LGGZi/Simple-n-cheap-A-pretty-nice-one-hand-Hall-Effect-Magnetic-Switch-Keyboard/PCB/BOM_Board1_Schematic1_2026-09-07.xlsx

No. | Quantity | Comment | Designator | Footprint | Value | Manufacturer Part | Manufacturer | Supplier Part | Supplier
1 | 1 | 470nF | C1 | C0603 | 470nF | CC0603KRX7R7BB474 | YAGEO(国巨) | C106851 | LCSC
2 | 6 | 100nF | C2,C3,C4,C5,C6,C7 | C0603 | 100nF | C0603C104J5RAC | KEMET(基美) | C490602 | LCSC
3 | 1 | 1uF | C8 | C0603 | 1uF | CL10A105KB8NNNC | SAMSUNG(三星) | C15849 | LCSC
4 | 2 | 22pF | C9,C10 | C0603 |  | CL10C220JB81PNC | SAMSUNG | C170132 | LCSC
5 | 14 | 100nF | C11,C12,C13,C14,C21,C22,C23,C24,C32,C33,C35,C36,C37,C38 | C0402 | 100nF | CL05B104KB54PNC | SAMSUNG(三星) | C307331 | LCSC
6 | 14 | 1uF | C15,C16,C17,C18,C19,C20,C25,C26,C27,C28,C29,C30,C39,C40 | C0402 | 1uF | GRM155R61E105KA12D | muRata(村田) | C77009 | LCSC
7 | 1 | Switch3x4x2 | KEY1 | KEY-3.0*4.0 |  | Switch3x4x2 | ReliaPro | C26638 | LCSC
8 | 1 | ATMEGA32U4-AU | MCU1 | QFP-44_L10.0-W10.0-P0.80-LS13.2-BL |  | ATMEGA32U4-AU | MICROCHIP(美国微芯) | C44854 | LCSC
9 | 1 | 1K | R1 | R0805 |  | TC0525F1001T5E | UniOhm | C75781 | LCSC
10 | 2 | 5.1K | R2,R3 | R0805 |  | 0805W8F5101T5E | UniOhm | C27834 | LCSC
11 | 1 | 10K | R4 | R0805 |  | 0805W8F1002T5E | UniOhm | C17414 | LCSC
12 | 3 | 1.5kΩ | R5,R6,R7 | R0402 | 1.5kΩ | 0402WGF1501TCE | UNI-ROYAL(厚声) | C25867 | LCSC
13 | 1 | 10kΩ | R8 | R0603 | 10kΩ | 0603WAF1002T5E | UNI-ROYAL(厚声) | C25804 | LCSC
14 | 2 | 22 | R9,R10 | R0603 |  | 0603WAF220JT5E | UniOhm | C23345 | LCSC
15 | 1 | 1kΩ | R11 | R0603 | 1kΩ | RC0603FR-071KL | YAGEO(国巨) | C22548 | LCSC
16 | 4 | M3螺丝 | SCREW1,SCREW2,SCREW3,SCREW4 | M3螺丝
17 | 1 | EC11E15244B2 | SW1 | 旋转编码器
18 | 1 | MF-NSMF050-2 | U1 | F1206 |  | MF-NSMF050-2 | BOURNS | C75464 | LCSC
19 | 14 | CH605ASR | U2,U3,U4,U5,U6,U7,U8,U9,U11,U12,U14,U15,U16,U17 | SOT-23-3_L2.9-W1.6-P1.90-LS2.8-BR |  | CH605ASR | COSEMITECH(意瑞) | C455296 | LCSC
20 | 2 | CD74HC4051M96 | U4057-1,U4058-1 | SOIC-16_L9.9-W3.9-P1.27-LS6.0-BL |  | CD74HC4051M96 | TI(德州仪器) | C132065 | LCSC
21 | 14 | Yo-WS2812B-3528反贴雾状 | UL1,UL2,UL3,UL4,UL5,UL6,UL7,UL8,UL9,UL10,UL11,UL12,UL13,UL14 | LED-SMD_L3.2-W2.8-BR_DY-S352818 |  | Yo-WS2812B-3528反贴雾状 | null | C9900003682 | LCSC
22 | 1 | PRTR5V0U2X | UPRT1 | SOT-143_L2.9-W1.3-P1.92-LS2.3-BL |  | PRTR5V0U2X | Yenji Elec | C330092 | LCSC
23 | 1 | TYPE-C-31-M-12 | USBC1 | USB-C_SMD-TYPE-C-31-M-12 |  | TYPE-C-31-M-12 | Rectangular Connectors - Contacts | C165948 | LCSC
24 | 1 | 16MHz | X1 | OSC-SMD_4P-L3.2-W2.5-BL |  | X322516MRB4SI | YXC | C70562 | LCSC
