LGGZi/Simple-n-cheap-A-pretty-nice-one-hand-Hall-Effect-Magnetic-Switch-Keyboard/PCB/PCB_PCB1_2026-09-07.pdf

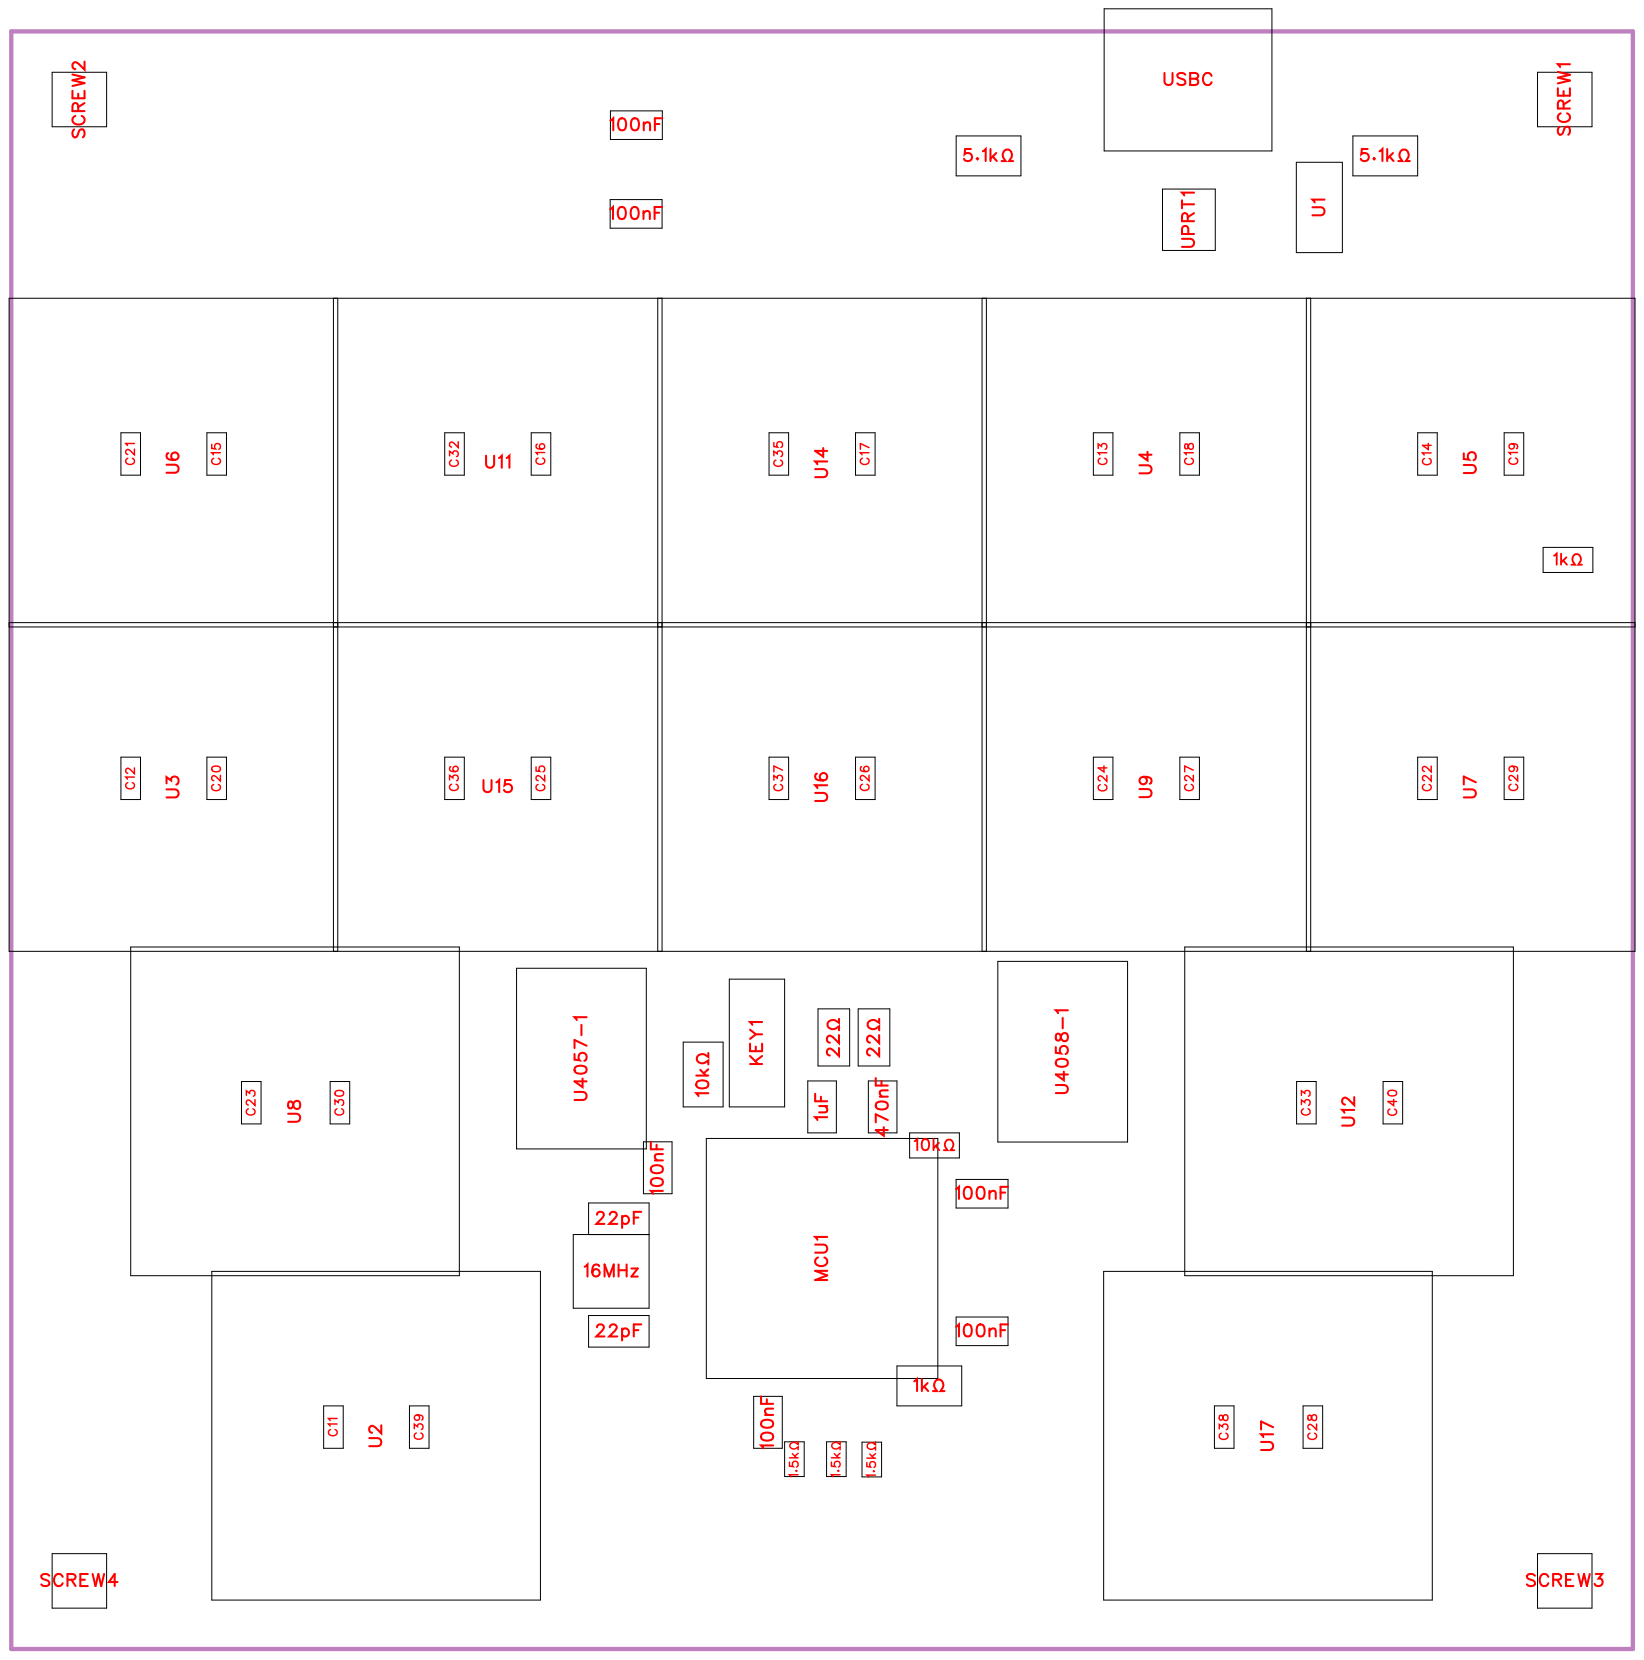
[picture p1: page 1]

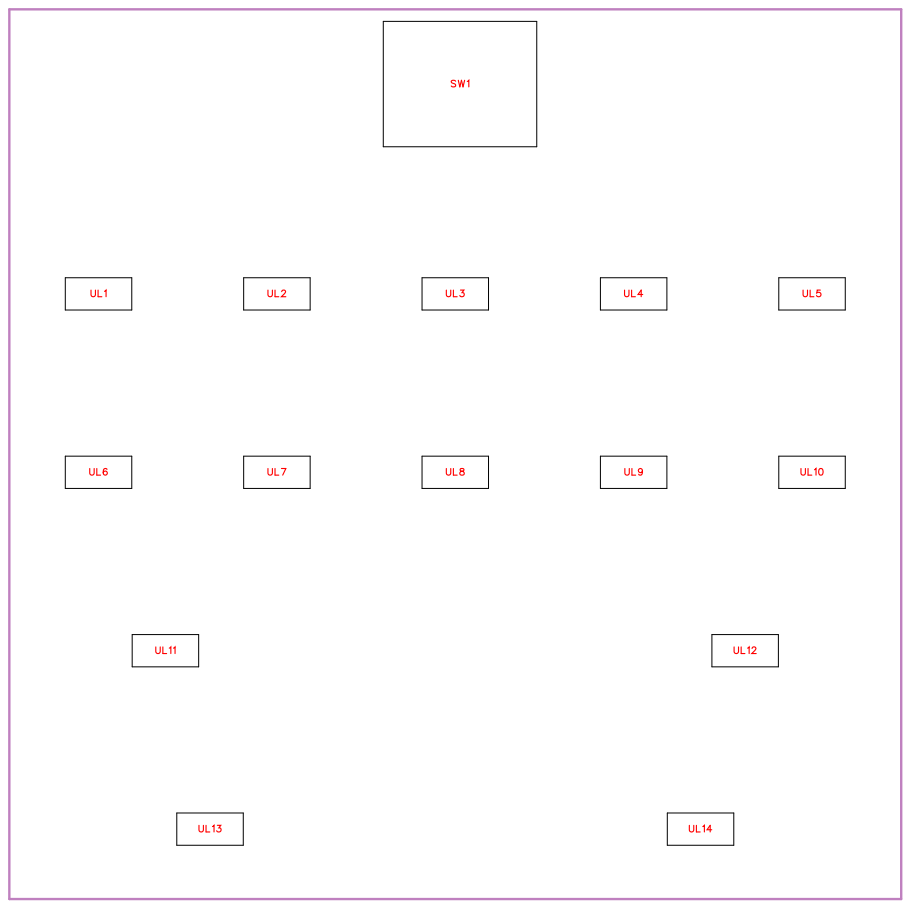
[picture p2: page 2]

No. | Quantity | Comment | Designator | Footprint | Value | Manufacturer Part | Manufacturer | Supplier Part | Supplier
1 | 1 | 1K | 1k | R0805 | | TC0525F100 1T5E | UniOhm | C75781 | LCSC
2 | 1 | 1k | 1k | R0603 | 1k | RC0603FR-0 71KL | YAGEO(国巨 ) | C22548 | LCSC
3 | 1 | 1uF | 1uF | C0603 | 1uF | CL10A105KB 8NNNC | SAMSUNG( 三星) | C15849 | LCSC
4 | 3 | 1.5k | 1.5k ,1.5k ,1.5k | R0402 | 1.5k | 0402WGF15 01TCE | UNI-ROYAL( 厚声) | C25867 | LCSC
5 | 2 | 5.1K | 5.1k ,5.1k | R0805 | | 0805W8F510 1T5E | UniOhm | C27834 | LCSC
6 | 1 | 10K | 10k | R0805 | | 0805W8F100 2T5E | UniOhm | C17414 | LCSC
7 | 1 | 10k | 10k | R0603 | 10k | 0603WAF10 02T5E | UNI-ROYAL( 厚声) | C25804 | LCSC
8 | 1 | 16MHz | 16MHz | OSC-SMD_4 P-L3.2-W2.5-BL | | X322516MR B4SI | YXC | C70562 | LCSC
9 | 2 | 22pF | 22pF,22pF | C0603 | | CL10C220JB 81PNC | SAMSUNG | C170132 | LCSC
10 | 2 | 22 | 22 ,22 | R0603 | | 0603WAF22 0JT5E | UniOhm | C23345 | LCSC
11 | 6 | 100nF | 100nF,100nF,100nF,100nF, 100nF,100nF | C0603 | 100nF | C0603C104J 5RAC | KEMET(基美 ) | C490602 | LCSC
12 | 1 | 470nF | 470nF | C0603 | 470nF | CC0603KRX 7R7BB474 | YAGEO(国巨 ) | C106851 | LCSC
13 | 14 | 100nF | C11,C12,C13,C14,C21,C22 ,C23,C24,C32,C33,C35,C3 6,C37,C38 | C0402 | 100nF | CL05B104KB 54PNC | SAMSUNG( 三星) | C307331 | LCSC
14 | 14 | 1uF | C15,C16,C17,C18,C19,C20 ,C25,C26,C27,C28,C29,C3 0,C39,C40 | C0402 | 1uF | GRM155R61 E105KA12D | muRata(村田 ) | C77009 | LCSC
15 | 1 | Switch3x4x2 | KEY1 | KEY-3.0*4.0 | | Switch3x4x2 | ReliaPro | C26638 | LCSC
16 | 1 | ATMEGA32U 4-AU | MCU1 | QFP-44_L10. 0-W10.0-P0. 80-LS13.2-B L | | ATMEGA32U 4-AU | MICROCHIP( 美国微芯) | C44854 | LCSC
17 | 4 | M3螺丝 | SCREW1,SCREW2,SCRE W3,SCREW4 | M3螺丝
18 | 1 | EC11E15244 B2 | SW1 | 旋转编码器
19 | 1 | MF-NSMF05 0-2 | U1 | F1206 | | MF-NSMF05 0-2 | BOURNS | C75464 | LCSC
20 | 14 | CH605ASR | U2,U3,U4,U5,U6,U7,U8,U9, U11,U12,U14,U15,U16,U17 | SOT-23-3_L2 .9-W1.6-P1.9 0-LS2.8-BR | | CH605ASR | COSEMITEC H(意瑞) | C455296 | LCSC
21 | 2 | CD74HC405 1M96 | U4057-1,U4058-1 | SOIC-16_L9. 9-W3.9-P1.2 7-LS6.0-BL | | CD74HC405 1M96 | TI(德州仪器) | C132065 | LCSC

22 | 14 | Yo-WS2812B -3528反贴雾 状 | UL1,UL2,UL3,UL4,UL5,UL6 ,UL7,UL8,UL9,UL10,UL11, UL12,UL13,UL14 | LED-SMD_L 3.2-W2.8-BR _DY-S35281 8 | Yo-WS2812B -3528反贴雾 状 | null | C990000368 2 | LCSC
23 | 1 | PRTR5V0U2 X | UPRT1 | SOT-143_L2. 9-W1.3-P1.9 2-LS2.3-BL | PRTR5V0U2 X | Yenji Elec | C330092 | LCSC
24 | 1 | TYPE-C-31-M-12 | USBC | USB-C_SMD -TYPE-C-31-M-12 | TYPE-C-31-M-12 | Rectangular Connectors -Contacts | C165948 | LCSC

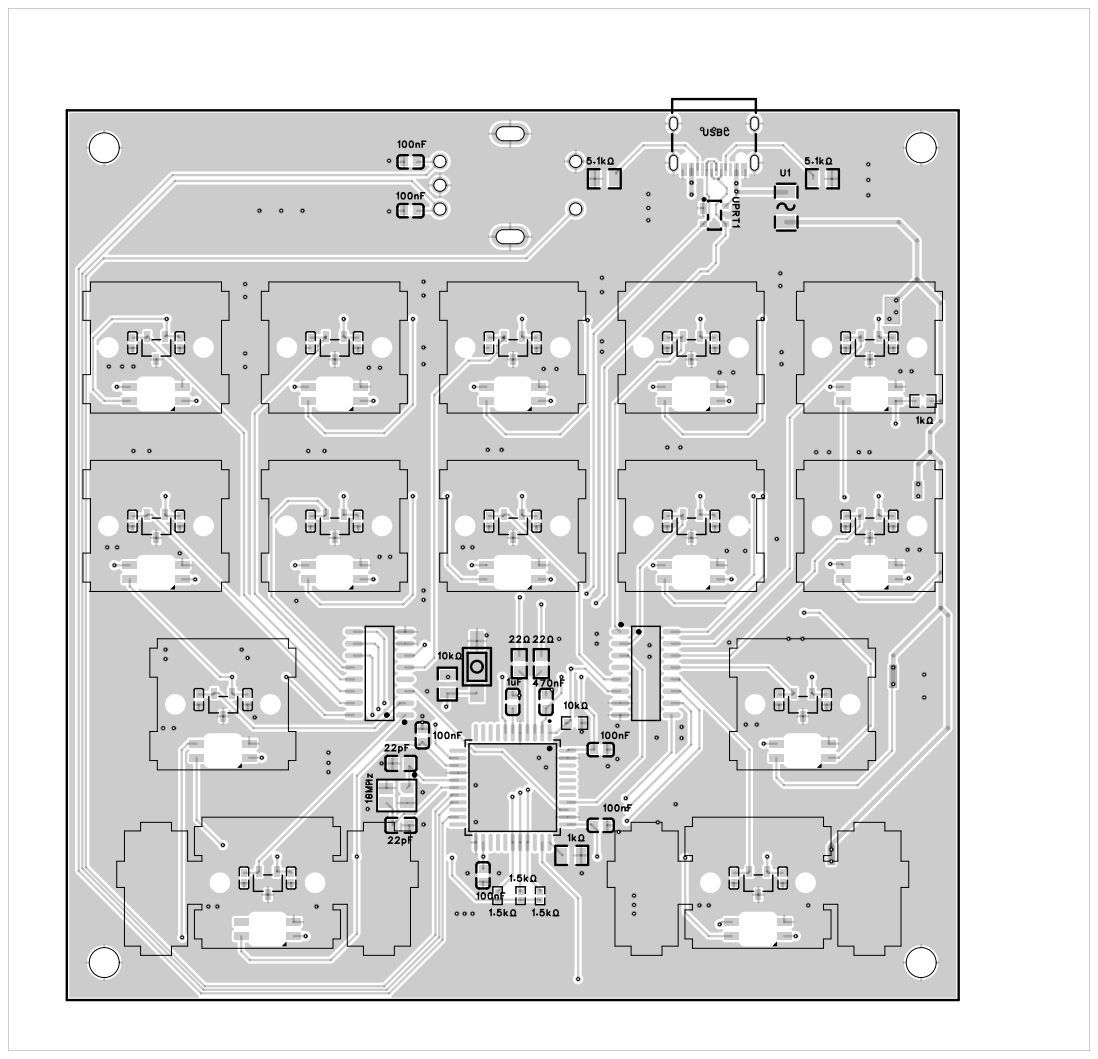
[picture p3: page 5]

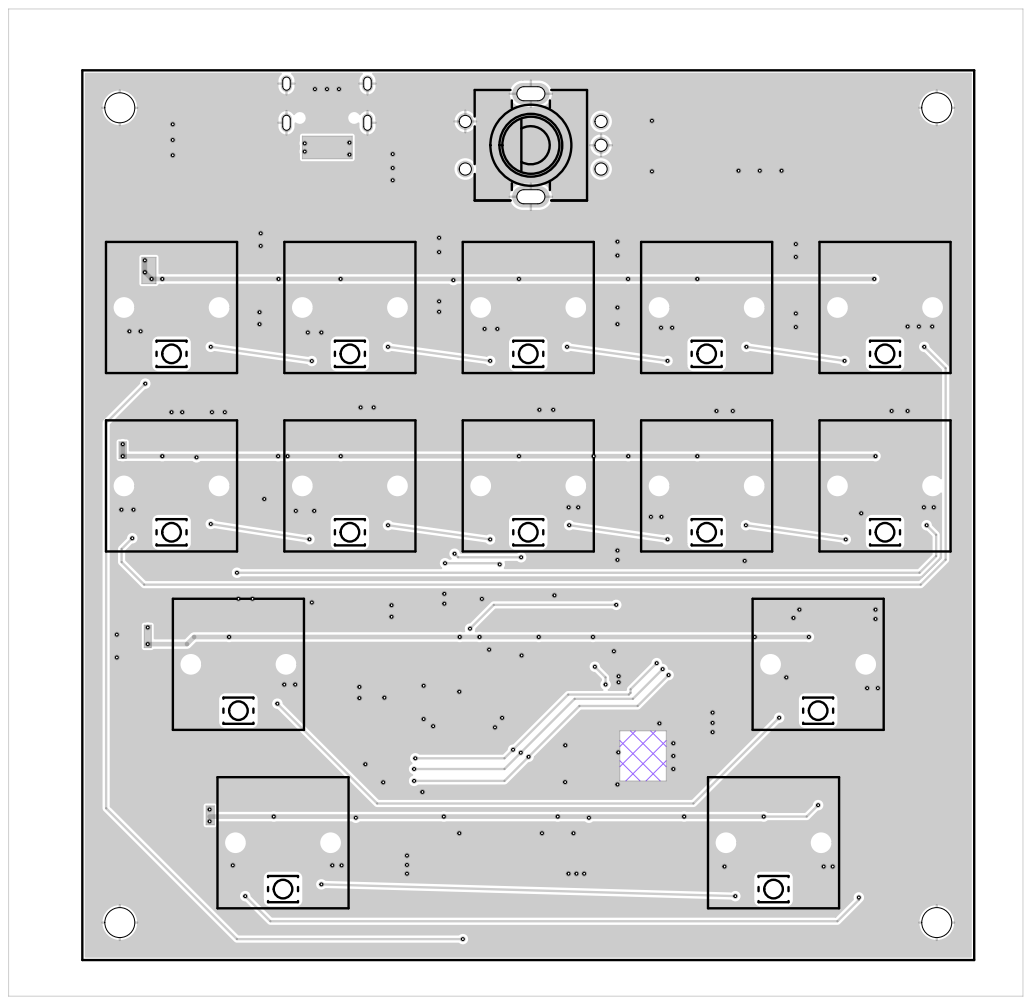
[picture p4: page 6]

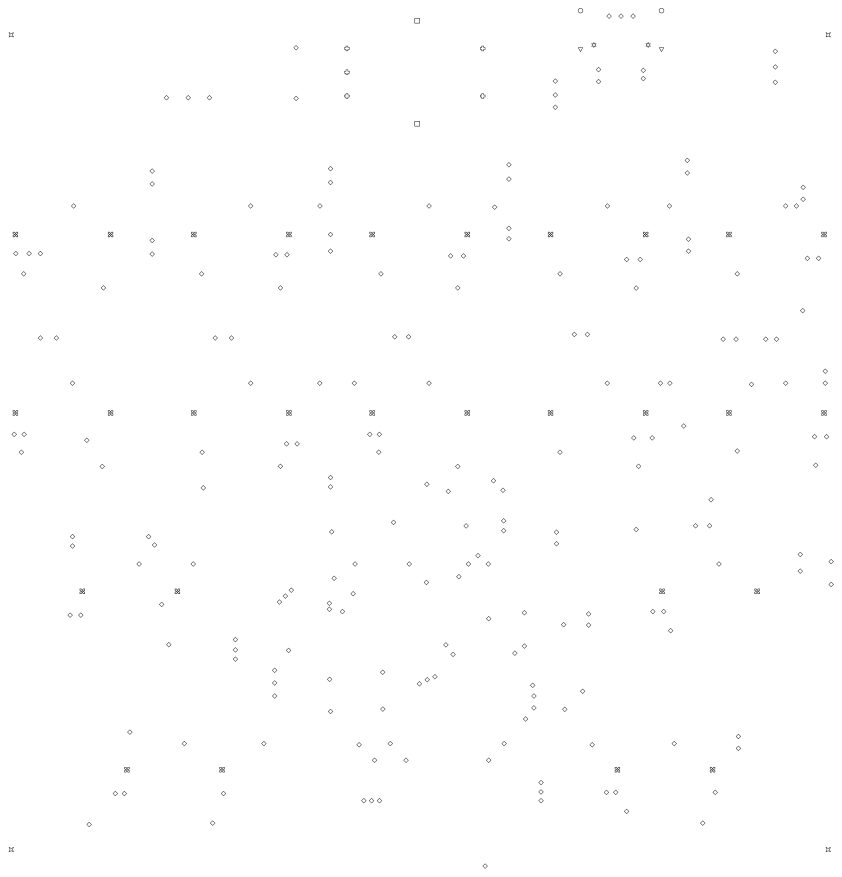
[picture p5: page 7]
