LGGZi/Simple-n-cheap-A-pretty-nice-one-hand-Hall-Effect-Magnetic-Switch-Keyboard/PCB/SCH_Schematic1_2026-09-07.pdf

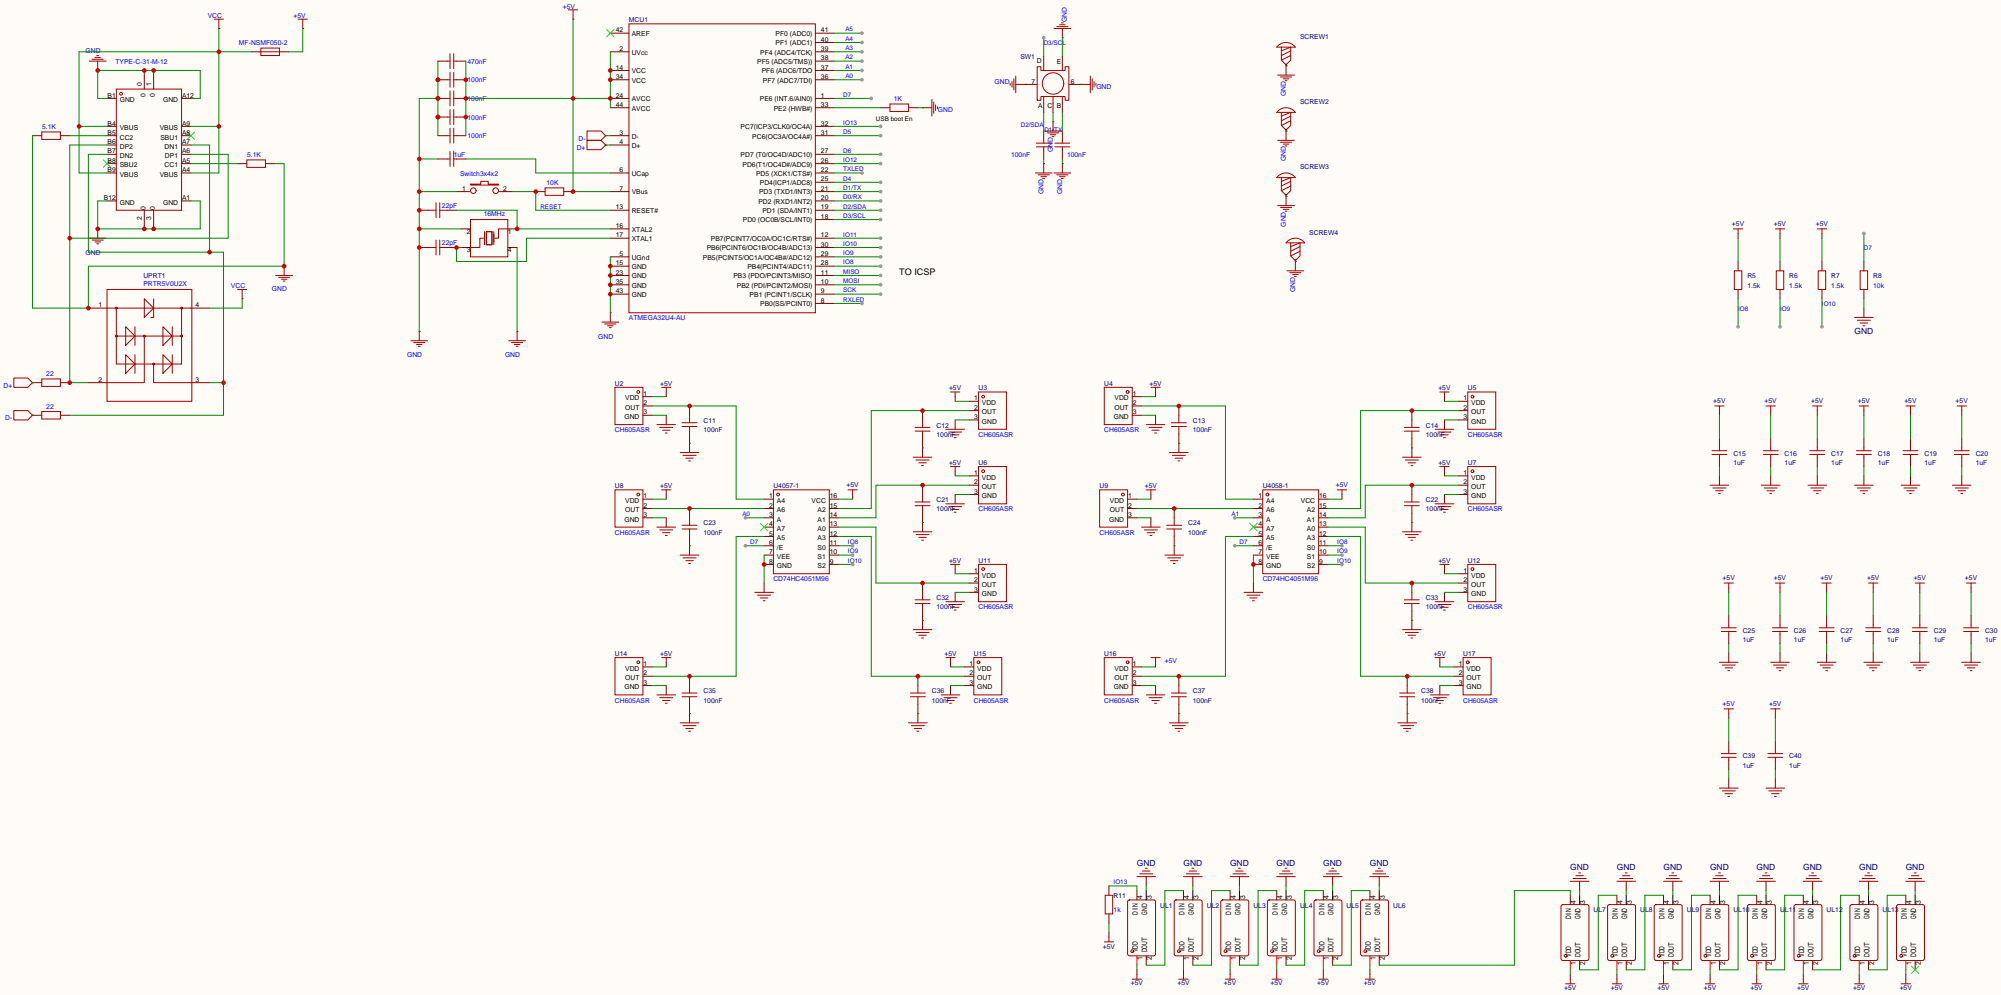
[picture p6: page 1]
