LGGZi/Simple-n-cheap-A-pretty-nice-one-hand-Hall-Effect-Magnetic-Switch-Keyboard/Code/rtkb-layout-edited/HIDcmdHandler.h

#ifndef HIDcmdHandler_h
#define HIDcmdHandler_h

#include <stdint.h>
#include "EEPROMManager.h"
#include "HallUnitManager.h"
#include "LayoutManager.h"
#include "KeyBehaviorEEPROM.h"   // 连发参数的 EEPROM 存读 / 应用
// Byte 1, CMD Code
#define CMD_SET_MAP      0x01
#define CMD_SET_PARAM    0x02
#define CMD_CALIBRATE    0x03
#define CMD_QUERY        0x04
#define CMD_ACK          0x05
#define CMD_FIN          0x06
#define CMD_REFRESH      0x07
#define CMD_SET_LED      0x08   // 即时设置灯效：[1]=effect [2]=亮度 [3]=速度 [4..6]=主色 RGB
#define CMD_SET_LED_ACCENT 0x09 // 即时设置副色：[1..3]=副色 RGB
#define CMD_SAVE_LED     0x0A   // 把当前灯效参数写进 EEPROM：[1]=0x5A 确认
#define CMD_SET_LED_FPS  0x0B   // 单独设置灯效刷新率：[1]=fps（10~200）
#define CMD_SET_RAPID    0x0C   // 设置连发参数：[1]=保留(开关只能由映射切换) [2]=脉宽 [3..4]=间隔 [5..6]=步长
#define CMD_SAVE_RAPID   0x0D   // 保存连发参数到 EEPROM：[1]=0x6C 确认

// Byte 2, Device, when mapping keys
#define NO_DEVICE 0x00
// 设备编号的“唯一来源”是 Universal.h（KEYBOARD / CONTROLLER / MOUSE / MULTIMEDIA …）。
// MAP_TYPE_* 只是给上位机指令用的可读别名，值必须跟 Universal.h 一致。
// 早期版本把 MOUSE / GAMEPAD 写成了 0x02 / 0x03（正好和 CONTROLLER=2、MOUSE=3 相反），
// 这两条宏当时没被任何代码使用、不影响功能，但换人接手容易埋坑；现在改成直接引用常量，
// 以后改 Universal.h 的编号这里会自动跟着变，不会再漂移。
#define MAP_TYPE_KEYBOARD   KEYBOARD        // 1
#define MAP_TYPE_GAMEPAD    CONTROLLER      // 2
#define MAP_TYPE_MOUSE      MOUSE           // 3
#define MAP_TYPE_CONSUMER   MULTIMEDIA      // 4
#define MAP_TYPE_CONTROLLER_XAXIS_LEFT   CONTROLLER_XAXIS_LEFT
#define MAP_TYPE_CONTROLLER_YAXIS_LEFT   CONTROLLER_YAXIS_LEFT
#define MAP_TYPE_CONTROLLER_XAXIS_RIGHT  CONTROLLER_XAXIS_RIGHT
#define MAP_TYPE_CONTROLLER_YAXIS_RIGHT  CONTROLLER_YAXIS_RIGHT
#define MAP_TYPE_MOUSE_X    MOUSE_X
#define MAP_TYPE_MOUSE_Y    MOUSE_Y
#define MAP_TYPE_CONTROLLER_LEFT_TRIGGER  CONTROLLER_LEFT_TRIGGER
#define MAP_TYPE_CONTROLLER_RIGHT_TRIGGER CONTROLLER_RIGHT_TRIGGER
// Byte 2, when setting parameter
#define RT_ACTIVE       0x04
#define RT_DEACTIVE     0x06
#define UPPER_DEADZONE  0x08
#define LOWER_DEADZONE  0x0A
// Byte 2, When calibrating：CQ_ALL / CQ_SINGLE
#define CQ_ALL     0x00
#define CQ_SINGLE  0x01
// Byte 2, When querying
#define QUERY_MAPPING       0x00
#define QUERY_PARAM         0x01
#define QUERY_CALIB         0x02
#define QUERY_DEVICE_INFO   0xFF
// 查询配列（布局）：[1] = QUERY_LAYOUT，固件逐键回 0xFE 帧后回 FIN
#define QUERY_LAYOUT        0xFE
// 查询灯效：回 0x0C / 0x0D 两帧，最后回 FIN
#define QUERY_LED           0x03
// 查询灯效的回传帧类型
#define LED_ITEM_BASIC      0x0C   // [1]=effect [2]=亮度 [3]=速度 [4]=fps
#define LED_ITEM_COLORS     0x0D   // [1..3]=主色 RGB [4..6]=副色 RGB
// 参数回传帧的 [0]（和 CMD_SET_PARAM 同号）
#define PARAM_ITEM          0x02
// 查询指令布局：[0]=CMD_QUERY [1]=查询内容 [2]=CQ_ALL/CQ_SINGLE [3]=按键号 [7]=序号
//Byte 2, When refresh
#define REFRESH_MAPPING       0x00
#define REFRESH_PARAM         0x01

// Byte 3, 
/*  Key number(mapping, parameter setting, calibrating single, querying single),
    ROW/COL number(calibrating or querying a line of keys)*/

// Byte 4, Report data offset/parameter value high byte

// Byte 5, Binding's operation when mapping
#define MAP_DO_APPEND   0x00
#define MAP_DO_OVERRIDE 0x01
#define MAP_DO_CLEAR    0x02



// Byte 6, when MAP_DO_OVERRIDE：该按键映射区里的第几个槽（0 开始，< MAX_BINDINGS_PER_KEY）/when MAP_DO_CLEAR：清空哪个按键，值为按键编号（0开始），BUTTONCOUNT为全部清空

uint8_t pre_cmd[8];

/*-------------------------------------------------------------
独立的设备信息报文：结构为 
[0xFF]、 [BUTTONCOUNT]、 [是否为磁轴0xF0 == y|0x0F == n]、 [编码器数量，0就是没有）]、 [设备类型（保留给后续手台主控使用）]、 
后二位保留、最后一位固件版本号
版本号格式示例 0 1 | 0 1 1 | 0 0 1  ==  1.31
前两位小数点前整数、中间三位小数点后一位、最后三位为小数点后第二位
*/
void HIDDeviceInfoUpload(){
    uint8_t resp[8] = { 0xFF, BUTTONCOUNT, 0xF0, 0x01, 0x01, LAYOUT_KIND, HOST_VERSION_REQUIRED, FIRMWARE_VERSION };
    HID().SendReport(4, resp, 8);
}

//收到指令立刻回的应答，格式与上位机发送的一致（Byte1 换成 CMD_ACK，其余保留）
void HIDSendAck(const uint8_t *cmdBytes) {
    uint8_t ack[8] = { CMD_ACK, cmdBytes[0], cmdBytes[7], 0, 0, 0, 0, 0 };
    HID().SendReport(4, ack, 8);
}
//一条指令处理完毕回的完成标志，格式同样与上位机发送的一致（Byte1 换成 CMD_FIN，其余原样回传），
//这样上位机既能确认收到了，也能确认执行完了（校准这种阻塞操作特别需要）
void HIDSendFin(const uint8_t *cmdBytes) {
    uint8_t fin[8];
    for(uint8_t i = 0; i < 8; i++){
        fin[i] = cmdBytes[i];
    }
    fin[0] = CMD_FIN;
    HID().SendReport(4, fin, 8);
}
//校准用：Byte3 写上刚校准完的按键号，上位机可以据此显示逐个校准的进度
void HIDSendCalibFin(const uint8_t *cmdBytes, uint8_t key) {
    uint8_t fin[8];
    for(uint8_t i = 0; i < 8; i++){
        fin[i] = cmdBytes[i];
    }
    fin[0] = CMD_FIN;
    fin[2] = key;
    HID().SendReport(4, fin, 8);
}

// ------------------------------------------------------------
// 查询上传：把查到的内容逐条发回去，每条都构造成"和上位机下发时一样的 8 字节"，
// 上位机可以直接复用下发那一套字段位置来解析：
//   键值：[0]=CMD_SET_MAP,   [1]=device, [2]=key, [3]=offset, [4]=MAP_DO_OVERRIDE, [5]=slot
//   参数：[0]=CMD_SET_PARAM, [1]=parameter, [2]=key, [3]=valueHi, [4]=valueLo
// 读 EEPROM 的动作在 EEPROMManager 里，这里只负责"读一条发一条"，保证原子性
// ------------------------------------------------------------
void HIDSendMapItem(uint8_t device, uint8_t key, uint8_t offset, uint8_t slot) {
    uint8_t resp[8] = { CMD_SET_MAP, device, key, offset, MAP_DO_OVERRIDE, slot, 0, 0 };
    HID().SendReport(4, resp, 8);
}
void HIDSendParamItem(uint8_t parameter, uint8_t key, uint16_t value) {
    uint8_t resp[8] = { CMD_SET_PARAM, parameter, key, (uint8_t)(value >> 8), (uint8_t)(value & 0xFF), 0, 0, 0 };
    HID().SendReport(4, resp, 8);
}

/*
  灯效参数上传：两帧（8 字节塞不下 11 个参数字节）
    [0]=0x0C  [1]=effect [2]=亮度 [3]=速度 [4]=fps
    [0]=0x0D  [1..3]=主色  [4..6]=副色
  两帧的 [7] 都回填查询指令的序号，上位机靠它配对。
*/
void HIDLedUpload(const uint8_t *cmd_buf) {
    uint8_t seq = cmd_buf[7];
    uint8_t basic[8] = {
        LED_ITEM_BASIC,
        ledParams.effect,
        ledParams.brightness,
        ledParams.speed,
        ledParams.fps,
        0, 0, seq
    };
    HID().SendReport(4, basic, 8);

    uint8_t colors[8] = {
        LED_ITEM_COLORS,
        ledParams.color1[0], ledParams.color1[1], ledParams.color1[2],
        ledParams.color2[0], ledParams.color2[1], ledParams.color2[2],
        seq
    };
    HID().SendReport(4, colors, 8);
}

/*
  连发参数查询（QUERY_PARAM 的一个参数组）：
    [1]=QUERY_PARAM  [2]=RAPID_TAB（复用 Byte3 当“参数组”，不是按键号）
  回传帧格式和磁轴参数一致：
    [0]=PARAM_ITEM [1]=参数码 [2]=参数组 [3..4]=值(高/低) [5..6]=0 [7]=序号
  一共 4 帧：开关 / 脉宽 / 间隔 / 步长（variation），之后由调用方补 FIN。
*/
void HIDParamUpload(const uint8_t *cmd_buf) {
    uint8_t group = cmd_buf[2];     //Byte3：参数组
    uint8_t seq   = cmd_buf[7];

    if (group != RAPID_TAB) {
        return;     //未知参数组：不发数据（上位机收到 FIN 就知道没有内容）
    }

    uint8_t frames[4][6] = {
        { RAPID_PARAM_TOGGLE,    RAPID_TAB, 0,           rk_args.toggle,    0, 0 },
        { RAPID_PARAM_PULSE,     RAPID_TAB, 0,           rk_args.pulse,     0, 0 },
        { RAPID_PARAM_INTERVAL,  RAPID_TAB, (uint8_t)(rk_args.interval >> 8),  (uint8_t)(rk_args.interval & 0xFF),  0, 0 },
        { RAPID_PARAM_VARIATION, RAPID_TAB, (uint8_t)(rk_args.variation >> 8), (uint8_t)(rk_args.variation & 0xFF), 0, 0 },
    };

    for (uint8_t i = 0; i < 4; i++) {
        uint8_t resp[8] = { PARAM_ITEM, frames[i][0], frames[i][1], frames[i][2], frames[i][3], frames[i][4], frames[i][5], seq };
        HID().SendReport(4, resp, 8);
    }
}

void HIDQueryUpload(uint8_t queryWhat, uint8_t queryScope, uint8_t key) {
    if(queryScope == CQ_SINGLE && !(key < BUTTONCOUNT)){
        return;   //单键查询的按键号非法
    }
    uint8_t first_key = (queryScope == CQ_SINGLE) ? key : 0;
    uint8_t last_key  = (queryScope == CQ_SINGLE) ? key : (BUTTONCOUNT - 1);
    const uint8_t params[4] = { RT_ACTIVE, RT_DEACTIVE, UPPER_DEADZONE, LOWER_DEADZONE };

    for(uint8_t k = first_key; k <= last_key; k++){
        if(queryWhat == QUERY_PARAM){
            for(uint8_t i = 0; i < 4; i++){
                HIDSendParamItem(params[i], k, keyParameterGetValue(k, params[i]));
            }
        }else{   //QUERY_MAPPING
            for(uint8_t slot = 0; slot < MAX_BINDINGS_PER_KEY; slot++){
                uint8_t offset = 0;
                uint8_t device = keyMapGetFromEEPROM(k, slot, &offset);
                if(device == NO_DEVICE){
                    break;   //空槽：本按键的映射到此为止
                }
                HIDSendMapItem(device, k, offset, slot);
            }
        }
    }
}
/**
 * 解析 8 字节 HID 报告（Report ID 4 的数据部分）
 * @param report 8字节数组指针
 */
void HIDcmdResponse(const uint8_t *report_cmd) {
    //先做一份快照：校准是阻塞操作，期间 USB 中断可能已经把 HIDcmd 改写成新指令，
    //如果一直引用 report_cmd，最后的 FIN 就会回成别的指令
    uint8_t cmd_buf[8];
    for(uint8_t i = 0; i < 8; i++){
        cmd_buf[i] = report_cmd[i];
    }
    HIDSendAck(cmd_buf);
    uint8_t cmd = cmd_buf[0];
    switch (cmd) {
        // ------------------------------------------------------------
        // 命令 1：修改按键映射
        // ------------------------------------------------------------
        case CMD_SET_MAP: {
            uint8_t operation = cmd_buf[4];      //Byte5
            switch (operation){
                case MAP_DO_APPEND:{
                    uint8_t device = cmd_buf[1]; //Byte2
                    uint8_t key = cmd_buf[2];    //Byte3
                    uint8_t offset = cmd_buf[3]; //Byte4
                    keyCodeAddToEEPROM(key, device, offset);
                break;
                }
                case MAP_DO_OVERRIDE:{
                    uint8_t device = cmd_buf[1];         //Byte2
                    uint8_t key = cmd_buf[2];            //Byte3
                    uint8_t offset = cmd_buf[3];         //Byte4
                    uint8_t slot = cmd_buf[5];   //Byte6：本按键的第几个映射槽
                    if(slot < MAX_BINDINGS_PER_KEY){
                        _keyCodeSetToEEPROM(key, slot, device, offset);
                    }
                break;
                }
                case MAP_DO_CLEAR:{
                    #if DEBUG
                        Serial.print("收到清空指令\n");
                    #endif
                    uint8_t key = cmd_buf[2];           //Byte3
                    uint8_t clear_whom = cmd_buf[5];    //Byte6
                    if(clear_whom == BUTTONCOUNT){
                        keyCodeClearAll();
                    }else if(clear_whom >= 0 && clear_whom < BUTTONCOUNT){
                        keyMapClearInEEPROM(key, clear_whom);
                        //写完后用这个指令，把它后面的槽全部设成空槽
                    }
                    keyCodeInit();
                break;
                }
            }
            HIDSendFin(cmd_buf);
        break;
        }
        // ------------------------------------------------------------
        // 命令 2：修改按键参数（磁轴四个参数）
        // ------------------------------------------------------------
        case CMD_SET_PARAM: {
            // ------------------------------------------------------------
            // 在此处调用的“修改参数”函数
            // ------------------------------------------------------------
            uint8_t parameter = cmd_buf[1];
            uint8_t key = cmd_buf[2];
            uint16_t value = (uint16_t)cmd_buf[3]  << 8 | cmd_buf[4];
            keyParameterSet(key, parameter, value);
            HIDSendFin(cmd_buf);
        break;
        }

        // ------------------------------------------------------------
        // 命令 3：校准操作
        // ------------------------------------------------------------
        case CMD_CALIBRATE: {
            uint8_t mode = cmd_buf[1];
            uint8_t offset = cmd_buf[2];
            if(mode == CQ_ALL){
                for(int i = 0; i < BUTTONCOUNT; i++){
                    calibrateKey(i);
                    //每个按键校准完立刻回一个带按键号的FIN，上位机可以据此显示逐个校准的进度；
                    //最后一个（i == BUTTONCOUNT-1）就是整条指令的完成标志，不再额外回FIN
                    HIDSendCalibFin(cmd_buf, (uint8_t)i);
                }
            }else if(mode == CQ_SINGLE){
                calibrateKey(offset);
                HIDSendCalibFin(cmd_buf, offset);
            }else{
                HIDSendFin(cmd_buf);
            }
        break;
        }

        // ------------------------------------------------------------
        // 命令 4：查询请求
        // [1]=查询内容(QUERY_MAPPING/QUERY_PARAM) [2]=CQ_ALL/CQ_SINGLE [3]=按键号
        // ------------------------------------------------------------
        case CMD_QUERY: {
            uint8_t query_what  = cmd_buf[1];   //Byte2
            uint8_t query_scope = cmd_buf[2];   //Byte3
            uint8_t key        = cmd_buf[3];   //Byte4
            if(query_what == QUERY_DEVICE_INFO){
                HIDDeviceInfoUpload();
            }else if(query_what == QUERY_LAYOUT){
                // 逐键上传布局，最后回 FIN（与其它查询一致）
                HIDLayoutUpload(cmd_buf);
                HIDSendFin(cmd_buf);
            }else if(query_what == QUERY_LED){
                HIDLedUpload(cmd_buf);
                HIDSendFin(cmd_buf);
            }else if(query_what == QUERY_PARAM && cmd_buf[2] == RAPID_TAB){
                // 连发参数组：Byte3（[2]）复用成“参数组”，RAPID_TAB 表示要连发参数
                HIDParamUpload(cmd_buf);
                HIDSendFin(cmd_buf);
            }else{
                HIDQueryUpload(query_what, query_scope, key);
                HIDSendFin(cmd_buf);
            }
        break;
        }
        // ------------------------------------------------------------
        // 命令 7：刷新请求
        // 字节2 = 刷新内容
        // ------------------------------------------------------------
        case CMD_REFRESH: {
            uint8_t refresh_what = cmd_buf[1];  //Byte2
            if(refresh_what == REFRESH_MAPPING){
                keyCodeInit();
            }else if(refresh_what == REFRESH_PARAM){
                keyParameterInit();
            }
            HIDSendFin(cmd_buf);
        break;
        }
        // ------------------------------------------------------------
        // 命令 8 / 9 / 10 / 11：灯效参数（即时生效 + 单独保存）
        // ------------------------------------------------------------
        case CMD_SET_LED: {
            wsSetEffect(cmd_buf[1]);                       //Byte2
            wsSetBrightness(cmd_buf[2]);                   //Byte3
            wsSetSpeed(cmd_buf[3]);                        //Byte4
            wsSetColor1RGB(cmd_buf[4], cmd_buf[5], cmd_buf[6]);   //Byte5~7
            HIDSendFin(cmd_buf);
        break;
        }
        case CMD_SET_LED_ACCENT: {
            wsSetColor2RGB(cmd_buf[1], cmd_buf[2], cmd_buf[3]);
            HIDSendFin(cmd_buf);
        break;
        }
        case CMD_SET_LED_FPS: {
            wsSetFps(cmd_buf[1]);
            HIDSendFin(cmd_buf);
        break;
        }
        case CMD_SAVE_LED: {
            //多一道确认字节，避免误发一条就把 EEPROM 写掉。
            //必须用 LED_SAVE_CONFIRM（0x5A），不能用结构体的 LED_PARAMS_MAGIC（0x5B）。
            if(cmd_buf[1] == LED_SAVE_CONFIRM){
                ledParamsSaveToEEPROM();
            }
            HIDSendFin(cmd_buf);
        break;
        }
        // ------------------------------------------------------------
        // 命令 12 / 13：连发参数（即时生效 + 单独保存）
        // [1]=开关(保留) [2]=脉宽 [3..4]=间隔 [5..6]=步长
        // ------------------------------------------------------------
        case CMD_SET_RAPID: {
            uint16_t interval  = ((uint16_t)cmd_buf[3] << 8) | cmd_buf[4];
            uint16_t variation = ((uint16_t)cmd_buf[5] << 8) | cmd_buf[6];
            rapidParamsApply(cmd_buf[1], cmd_buf[2], interval, variation);
            HIDSendFin(cmd_buf);
        break;
        }
        case CMD_SAVE_RAPID: {
            if(cmd_buf[1] == RAPID_SAVE_CONFIRM){
                //保存前强制开启：否则用户在“关闭”状态下保存，下次上电默认就是关的
                rk_args.toggle = 1;
                rapidParamsSaveToEEPROM();
            }
            HIDSendFin(cmd_buf);
        break;
        }
        default:
            // 未知命令码：也回一个 FIN，免得上位机一直等在那
            HIDSendFin(cmd_buf);
        break;
    }
}

void HIDcmdResponseIfChanged(){
    if(memcmp(pre_cmd, HIDcmd, 8) != 0){
        // Serial.print("cmd get\n");
        HIDcmdResponse(HIDcmd);
        memcpy(pre_cmd, HIDcmd, 8);
    }
}
#endif
