LGGZi/Simple-n-cheap-A-pretty-nice-one-hand-Hall-Effect-Magnetic-Switch-Keyboard/Code/rtkb-layout-edited/EEPROMManager.h

#ifndef EEPROMManager_h
#define EEPROMManager_h
#include "Universal.h"
#include <EEPROM.h>
#include "WS2812BManager.h"      // ledParams / LEDParams_t / 灯效编号
#include "KeyBehaviorManager.h"   // keyCodeInit() 末尾要调 stickyKeyInit()
#define PSOOSK 12  //aka. Parameter size of one single key, should be adjusted if you need more space to storage other parameters.
//映射区起始位置，紧跟在按键参数区之后
#define KEYMAP_START_POSITION (BUTTONCOUNT * PSOOSK)

//灯效参数区：紧跟映射区，sizeof(LEDParams_t) = 11 字节（和 6kb 一致）
#define LED_PARAMS_START_POSITION (KEYMAP_START_POSITION + BUTTONCOUNT * KEYMAP_SIZE_PER_KEY)

//结构体实际是 11 字节。注意 6kb 的 README 写的“10 字节 / 偏移 155”是笔误：
//6kb 代码用 sizeof 算位置（连发参数实际在 156），这里保持一致。
static_assert(sizeof(LEDParams_t) == 11,
              "LEDParams_t 布局变了（magic/effect/brightness/speed/fps/color1/color2 = 11 字节）");

//按 (key, slot) 直接算出映射在 EEPROM 里的位置：
//每个按键占 KEYMAP_SIZE_PER_KEY 字节，按键之间依次紧挨；
//每个映射占 2 字节：(device, offset)
int keyMapSlotToEEPROMIndex(uint8_t key, uint8_t slot){
  return KEYMAP_START_POSITION + (key * KEYMAP_SIZE_PER_KEY) + (slot * 2);
}

//EEPROM 没写过的字节读出来是 0xFF（擦除态）；一个映射槽里的 device 只可能是
//KEYBOARD..MULTIMEDIA(1~4)。所以只要读到的值不在这段范围里 ——
//0（正常空槽）、0xFF（没写过）、或者旧格式的残留数据 —— 一律按"空槽"处理。
bool keyMapSlotIsEmpty(uint8_t device){
  return ( (device == NO_DEVICE) || (device == 0xFF) );
}

//-------- 供 HIDcmdHandler 的查询功能调用，这里只负责从 EEPROM 取数据 --------
//读取某个按键第 slot 个映射：device 作为返回值（NO_DEVICE 表示空槽），offset 由指针带回
uint8_t keyMapGetFromEEPROM(uint8_t key, uint8_t slot, uint8_t *offset){
  int index = keyMapSlotToEEPROMIndex(key, slot);
  uint8_t device = 0;
  uint8_t off = 0;
  EEPROM.get(index, device);
  EEPROM.get(index + 1, off);
  if(keyMapSlotIsEmpty(device)){
    *offset = 0;
    return NO_DEVICE;   //0xFF / 残留数据都按空槽返回
  }
  *offset = off;
  return device;
}

//读取某个按键某个磁轴参数的原始值（千分比，还没换算成行程）
uint16_t keyParameterGetValue(uint8_t key, uint8_t valName){
  uint16_t value = 0;
  EEPROM.get((PSOOSK * key + valName), value);
  return value;
}

//把某个按键从 slot 开始（含 slot）往后的所有槽的 device 都设成 NO_DEVICE，
//也就是把"这个按键从第 slot 条以后"的映射全部清掉。
//读映射时遇到空槽就会停，所以调用方只需要按顺序发它有的那几条映射，
//不用再逐条补发空槽（NO_DEVICE 就是 0，用宏写更清楚）。
//注意：只要传进来的 slot < MAX_BINDINGS_PER_KEY 就不会越界；
//改 BUTTONCOUNT / MAX_BINDINGS_PER_KEY 时请自行核对映射区总大小（见 Universal.h）
void keyMapClearInEEPROM(uint8_t key, uint8_t slot){
  if(!(key < BUTTONCOUNT) || !(slot < MAX_BINDINGS_PER_KEY)){
    return;
  }
  for(uint8_t s = slot; s < MAX_BINDINGS_PER_KEY; s++){
    if(EEPROM.read(keyMapSlotToEEPROMIndex(key, s)) != NO_DEVICE){
      EEPROM.write(keyMapSlotToEEPROMIndex(key, s), NO_DEVICE);
    }
  }
}

void keyParameterSet(int8_t key, int8_t valName, uint16_t value) {
  #if DEBUG
    Serial.print("ParameterSet:  ");
    Serial.print("key=");
    Serial.print(key);
    Serial.print("   ");
    Serial.print("valName=");
    Serial.print(valName);
    Serial.print("   ");
    Serial.print("value=");
    Serial.println(value);
  #endif
  if (key >= 0 && key < BUTTONCOUNT) {
    // 按参数分别限制范围（单位和 EEPROM 里一致：千分比，1000 = 满行程）
    //   RT 触发行程 / RT 释放行程：10 ~ 500  （1% ~ 50%）
    //   上死区 / 下死区：          0 ~ 200    （0 ~ 20%，0 = 关闭死区）
    //   校准极值 MAX_VALUE / MIN_VALUE：原始 ADC 值，0 ~ 1023
    bool accept = false;
    if (valName == RT_ACTIVE || valName == RT_DEACTIVE) {
      accept = (value >= 10 && value <= 500);
    } else if (valName == UPPER_DEADZONE || valName == LOWER_DEADZONE) {
      accept = (value <= 200);
    } else if (valName == MAX_VALUE || valName == MIN_VALUE) {
      accept = (value <= 1023);
    }
    if (accept) {
      EEPROM.put((PSOOSK * key + valName), value);
    }
  }
}
void parameterRefresh(int8_t key) {
  uint16_t temp = 0;
  EEPROM.get((PSOOSK * key + RT_ACTIVE), temp);
  rt_active[key] = (bt_maximum[key] - bt_minimum[key]) * ((double)temp / 1000);
  EEPROM.get((PSOOSK * key + RT_DEACTIVE), temp);
  rt_deactive[key] = (bt_maximum[key] - bt_minimum[key]) * ((double)temp / 1000);
  EEPROM.get((PSOOSK * key + UPPER_DEADZONE), temp);
  high_deadzone[key] = (bt_maximum[key] - bt_minimum[key]) * ((double)temp / 1000);
  EEPROM.get((PSOOSK * key + LOWER_DEADZONE), temp);
  low_deadzone[key] = (bt_maximum[key] - bt_minimum[key]) * ((double)temp / 1000);
}
void keyParameterGetFromEEPROM(int8_t key, int8_t valName) {
  #if DEBUG
    // Serial.print("Func--Get:");
    // Serial.print("key=");
    // Serial.print(key);
    // Serial.print("   ");
    // Serial.print("valName=");
    // Serial.print(valName);
    // Serial.print("   \n");
  #endif
  uint16_t temp = 0;
  switch (valName) {
    case MAX_VALUE:
      EEPROM.get((PSOOSK * key + valName), bt_maximum[key]);
      break;
    case MIN_VALUE:
      EEPROM.get((PSOOSK * key + valName), bt_minimum[key]);
      break;
    case RT_ACTIVE:
      EEPROM.get((PSOOSK * key + valName), temp);
      rt_active[key] = (bt_maximum[key] - bt_minimum[key]) * ((double)temp / 1000);
      break;
    case RT_DEACTIVE:
      EEPROM.get((PSOOSK * key + valName), temp);
      rt_deactive[key] = (bt_maximum[key] - bt_minimum[key]) * ((double)temp / 1000);
      break;
    case UPPER_DEADZONE:
      EEPROM.get((PSOOSK * key + valName), temp);
      high_deadzone[key] = (bt_maximum[key] - bt_minimum[key]) * ((double)temp / 1000);
      break;
    case LOWER_DEADZONE:
      EEPROM.get((PSOOSK * key + valName), temp);
      low_deadzone[key] = (bt_maximum[key] - bt_minimum[key]) * ((double)temp / 1000);
      break;
  }
}
uint8_t _keyCodeSetToEEPROM(uint8_t key, uint8_t slot, uint8_t device, uint8_t offset) {
  //索引由 (key, slot) 直接算出，不再做 EEPROM 越界检查（见 Universal.h 的说明），
  //只保证 key / slot 合法，否则会写到别的按键的映射区里去
  if(!(key < BUTTONCOUNT) || !(slot < MAX_BINDINGS_PER_KEY)){
    return 2;
  }
  int index = keyMapSlotToEEPROMIndex(key, slot);
  EEPROM.write(index, device);
  EEPROM.write(index + 1, offset);
  #if DEBUG
    sprintf(buff, "EEPROM操作:key = %d, slot = %d, device = %d, offset = %d", key, slot, device, offset);
    Serial.println(buff);
    sprintf(buff, "Real Index %d", index);
    Serial.println(buff);
  #endif
  return 0;
}

uint8_t keyCodeAddToEEPROM(uint8_t key, uint8_t device, uint8_t offset) {
  if(!(key < BUTTONCOUNT)){
    return 2;
  }
  //从该按键自己的映射区里找第一个空槽追加（0 和 0xFF 都算空槽）
  for(uint8_t slot = 0; slot < MAX_BINDINGS_PER_KEY; slot++){
    if(keyMapSlotIsEmpty(EEPROM.read(keyMapSlotToEEPROMIndex(key, slot)))){
      _keyCodeSetToEEPROM(key, slot, device, offset);
      #if DEBUG
        sprintf(buff, "映射追加:key = %d, slot = %d", key, slot);
        Serial.println(buff);
      #endif
      return 0;
    }
  }
  #if DEBUG
    sprintf(buff, "映射追加失败:按键 %d 的 %d 个映射槽已满", key, MAX_BINDINGS_PER_KEY);
    Serial.println(buff);
  #endif
  return 1;
}

uint8_t offsetToArrayIndex(uint8_t offset){
  uint8_t high_bits = offset / 8;
  uint8_t low_bits = offset % 8;
  #if DEBUG
    sprintf(buff, "检测到为键盘设备 high_bits = %d , low_bits = %d", high_bits, low_bits);
    Serial.println(buff);
  #endif
  return (high_bits << 4) | low_bits;
}
void keyMapAppend(uint8_t key, uint8_t device, uint8_t offset){
  if(key < BUTTONCOUNT){
    for(uint8_t i = 0; i < MAX_BINDINGS_PER_KEY; i++){
      if(key_map[key][i][0] == NO_DEVICE){
        if( (device & 0x0F) == KEYBOARD){
          key_map[key][i][0] = device;
          key_map[key][i][1] = offsetToArrayIndex(offset);
          break;
        }else{
          key_map[key][i][0] = device;
          key_map[key][i][1] = offset;
          break;
        }
      }
    }
  }else{
    
  }
  
}

void keyCodeGetFromEEPROM(uint8_t key){
  //一个按键一个按键地读：读到空槽（device 不是 1~4）说明本按键的映射到此为止，
  //或者已经读满 MAX_BINDINGS_PER_KEY 个也停
  for(uint8_t slot = 0; slot < MAX_BINDINGS_PER_KEY; slot++){
    int index = keyMapSlotToEEPROMIndex(key, slot);
    uint8_t device = 0;
    uint8_t offset = 0;
    EEPROM.get(index, device);
    EEPROM.get(index + 1, offset);
    if(keyMapSlotIsEmpty(device)){
      break;   //空槽 / 0xFF（没写过）/ 残留数据：本按键的映射到此为止
    }
    #if DEBUG
      sprintf(buff, "获得EEPROM的数据:key = %d, slot = %d, device = %d, offset = %d", key, slot, device, offset);
      Serial.println(buff);
    #endif
    keyMapAppend(key, device, offset);
  }
}
void keyCodeClearAll(){
  //清每个映射槽的 device
  //device为0后面对应的 offset 不会再被读到
  #if DEBUG
    Serial.print("清空映射\n");
  #endif
  for(uint8_t key = 0; key < BUTTONCOUNT; key++){
    keyMapClearInEEPROM(key, 0);
  }
}
void keyCodeInit() {
  memset(key_map, 0, sizeof(key_map));
  for(uint8_t key = 0; key < BUTTONCOUNT; key++){
    keyCodeGetFromEEPROM(key);
  }
  stickyKeyInit();
}

void keyParameterInit() {
  for (int i = 0; i < BUTTONCOUNT; i++) {
    keyParameterGetFromEEPROM(i, MAX_VALUE);
    keyParameterGetFromEEPROM(i, MIN_VALUE);
    keyParameterGetFromEEPROM(i, RT_ACTIVE);
    keyParameterGetFromEEPROM(i, RT_DEACTIVE);
    keyParameterGetFromEEPROM(i, UPPER_DEADZONE);
    keyParameterGetFromEEPROM(i, LOWER_DEADZONE);
  }
}

//-------- 灯效参数：整块结构体直接存 / 读（和 6kb 一样）--------
bool ledParamsAreValid(const LEDParams_t *p){
  return p->magic == LED_PARAMS_MAGIC
      && p->effect < LED_EFFECT_COUNT
      && p->speed >= LED_SPEED_MIN
      && p->speed <= LED_SPEED_MAX
      && p->fps >= LED_FPS_MIN
      && p->fps <= LED_FPS_MAX;
}

//把全局 ledParams 整块写进 EEPROM（调用前先把 magic 补上）
void ledParamsSaveToEEPROM(){
  ledParams.magic = LED_PARAMS_MAGIC;
  EEPROM.put(LED_PARAMS_START_POSITION, ledParams);
}

//上电读一次：有效就 memcpy 到全局结构体，无效（0xFF / 旧数据）就写默认值并保存
void ledParamsGetFromEEPROM(){
  LEDParams_t temp;
  EEPROM.get(LED_PARAMS_START_POSITION, temp);
  if(ledParamsAreValid(&temp)){
    memcpy(&ledParams, &temp, sizeof(LEDParams_t));
  }else{
    ledParamsSetDefault();
    ledParamsSaveToEEPROM();
  }
  wsApplyParams();
}
#if DEBUG
  void showBinding(uint8_t key, uint8_t slot){
    int index = keyMapSlotToEEPROMIndex(key, slot);
    uint8_t device = 0;
    uint8_t offset = 0;
    EEPROM.get(index, device);
    EEPROM.get(index + 1, offset);
      sprintf(buff, "读取EEPROM的数据:key = %d, slot = %d, device = %d, offset = %d", key, slot, device, offset);
      Serial.println(buff);
      sprintf(buff, "Real Index %d", index);
      Serial.println(buff);
  }

  void showAllBindings(){
    for(int key = 0; key < BUTTONCOUNT; key++){
      for(int slot = 0; slot < MAX_BINDINGS_PER_KEY; slot++){
        showBinding(key, slot);
      }
    }
  }
#endif
#endif
