LGGZi/Simple-n-cheap-A-pretty-nice-one-hand-Hall-Effect-Magnetic-Switch-Keyboard/Code/rtkb-layout-edited/LayoutManager.h

#ifndef LayoutManager_h
#define LayoutManager_h

#include <stdint.h>
#include <avr/pgmspace.h>
#include "Universal.h"      // BUTTONCOUNT / FIRMWARE_VERSION
#include "SubHID.h"         // HID()

/*-------------------------------------------------------------
 * 配列（布局）上传
 *
 * 设备信息报文 [5] = layoutKind：
 *   0x00          旧设备，不上传布局，上位机按固定网格显示
 *   0xFF          自定义布局，按本文件的 layout_custom 上传
 *   0x01 ~ 0xFE   预留给内置布局 ID
 *
 * 查询：QUERY 的 [1] = QUERY_LAYOUT (0xFE)
 *   固件逐键回 0xFE 帧（每键一帧），最后回 FIN。
 *
 * 坐标：0.25u 一个单位（4 = 1u），左上角 (0,0)，x 向右、y 向下。
 * flags：bit7|bit6 = 11 → 该键需要旋转（旋转数据二期用 0xFD 帧上传）
 *        bit5..bit0    → 按键类型
 *-------------------------------------------------------------*/

#define LAYOUT_KIND_NONE    0x00
#define LAYOUT_KIND_CUSTOM  0xFF
#define LAYOUT_FRAME_ITEM   0xFE
#define LAYOUT_UNITS_PER_U  4
#define LAYOUT_FLAG_ROTATE  0xC0

#define KEY_TYPE_NORMAL     0
#define KEY_TYPE_MODIFIER   1
#define KEY_TYPE_ENCODER    2
#define KEY_TYPE_DECOR      3

struct KeyLayoutItem {
    uint8_t x, y, w, h, flags;   // 坐标与尺寸单位为 0.25u
};

/* 二期：旋转组（结构先占位，固件暂不上传） */
struct LayoutRotation {
    uint8_t first;   // 组内第一个按键索引
    uint8_t rx, ry;  // 旋转中心，0.25u
    uint8_t angle;   // 0.5° / 单位
    uint8_t group;
    uint8_t count;
};

/*-------------------------------------------------------------
 * 布局表
 *   用 tools/kle2c.py 从 keyboard-layout-editor 的 Raw data 生成后替换下面整段。
 *   已由 tools/kle2c.py 从 rtkb14.json 生成（14 键）。
 *-------------------------------------------------------------*/
/* Generated by tools/kle2c.py from rtkb14.json on 2026-10-19.
 * 14 keys, bounding box 5.00u x 4.00u (20 x 16 units of 0.25u).
 * Order: top to bottom, left to right. Keep key_map indices identical.
 * Paste the array below into LayoutManager.h (replace layout_custom).
 */
const KeyLayoutItem layout_custom[] PROGMEM = {
    {   0,   0,   4,   4, 0x00 },  /*   0:            x=0.00u y=0.00u w=1.00u h=1.00u */
    {   4,   0,   4,   4, 0x00 },  /*   1:            x=1.00u y=0.00u w=1.00u h=1.00u */
    {   8,   0,   4,   4, 0x00 },  /*   2:            x=2.00u y=0.00u w=1.00u h=1.00u */
    {  12,   0,   4,   4, 0x00 },  /*   3:            x=3.00u y=0.00u w=1.00u h=1.00u */
    {  16,   0,   4,   4, 0x00 },  /*   4:            x=4.00u y=0.00u w=1.00u h=1.00u */
    {   0,   4,   4,   4, 0x00 },  /*   5:            x=0.00u y=1.00u w=1.00u h=1.00u */
    {   4,   4,   4,   4, 0x00 },  /*   6:            x=1.00u y=1.00u w=1.00u h=1.00u */
    {   8,   4,   4,   4, 0x00 },  /*   7:            x=2.00u y=1.00u w=1.00u h=1.00u */
    {  12,   4,   4,   4, 0x00 },  /*   8:            x=3.00u y=1.00u w=1.00u h=1.00u */
    {  16,   4,   4,   4, 0x00 },  /*   9:            x=4.00u y=1.00u w=1.00u h=1.00u */
    {   0,   8,   8,   4, 0x00 },  /*  10:            x=0.00u y=2.00u w=2.00u h=1.00u */
    {  12,   8,   8,   4, 0x00 },  /*  11:            x=3.00u y=2.00u w=2.00u h=1.00u */
    {   1,  12,   8,   4, 0x00 },  /*  12:            x=0.25u y=3.00u w=2.00u h=1.00u */
    {  11,  12,   8,   4, 0x00 },  /*  13:            x=2.75u y=3.00u w=2.00u h=1.00u */
};

/* 数量必须与 BUTTONCOUNT 一致（编译期检查） */
static_assert(sizeof(layout_custom) / sizeof(layout_custom[0]) == BUTTONCOUNT,
              "layout table must match BUTTONCOUNT");

/* 本固件提供自定义布局 */
#define LAYOUT_KIND LAYOUT_KIND_CUSTOM

/* 逐键上传布局：每键一帧 0xFE，序号沿用下发指令的 [7] */
void HIDLayoutUpload(const uint8_t *cmdBytes){
    for(uint8_t i = 0; i < BUTTONCOUNT; i++){
        KeyLayoutItem item;
        memcpy_P(&item, &layout_custom[i], sizeof(item));
        uint8_t resp[8] = { LAYOUT_FRAME_ITEM, i, item.x, item.y, item.w, item.h, item.flags, cmdBytes[7] };
        HID().SendReport(4, resp, 8);
    }
}

#endif
