LGGZi/Simple-n-cheap-A-pretty-nice-one-hand-Hall-Effect-Magnetic-Switch-Keyboard/(commit log)

2026-09-10 Divide Hall Unit and EEPROM operation
    Divide Hall Unit and EEPROM operation, prepare for further HIDcmd function.
2026-10-19 Firmware 1.04: layout upload, hall state fix and documentation
    - device info byte [5] reports layoutKind (0xFF = custom layout)
    - QUERY_LAYOUT (0xFE): one frame per key with x/y/w/h in 0.25u units
    - LayoutManager.h: 14-key layout table generated from keyboard-layout-editor
    - HallUnitManager: keep the pressed-key bitmap across scans (static buttonbuf),
    so a key stays pressed between transitions instead of dropping out
    - README.md: firmware structure, scan/RT state machine, EEPROM map and protocol
2026-10-20 Firmware: deadzone-first key state machine, per-parameter limits
    - getKeyState(): check the dead zones first; inside a dead zone the opposite
    threshold is pinned at boundary +/- travel, so a release triggered by the
    dead zone can never re-trigger on a 1-2 count wobble (double click fix)
    - parameter limits: RT active/release 10..500 per-mille (1..50%),
    upper/lower dead zone 0..200 per-mille (0 = dead zone disabled)
    - keyParameterSet() also persists the calibration extremes (MAX/MIN),
    so a calibration survives a power cycle
    - encoder button (calibrateAll) re-enabled in loop
2026-10-20 firmware: device info byte [6] carries the required host version
    - Universal.h: HOST_VERSION_REQUIRED = 0x47 (2|3|3 packing, 1.07)
    - HIDDeviceInfoUpload(): [6] now reports it instead of a reserved zero, so the
    host can compare it with its own version and warn when it is too old
    - README: document [6] (required host version) and [7] (firmware version)
2026-10-20 docs: bilingual README
    - README.md rewritten and README.en.md added: dead-zone-first state machine,
    parameter ranges (RT 10..500, dead zones 0..200, calibration 0..1023), EEPROM map,
    device info [6] = required host version and [7] = firmware version, protocol and
    debug notes.
2026-10-20 docs: rewrite the root README in the host-tool style (bilingual)
    - README.md is now Chinese and README.en.md English, cross-linked, following the
    structure of the KeyboardOG README: badges, rapid trigger / dead zones, calibration,
    mappings, encoder, layout upload, version handshake, quick start, hardware table,
    build instructions, repo layout, protocol summary, FAQ, to-do, credits
    - links to the code-level docs in Code/rtkb-layout-edited/README(.en).md
2026-10-20 Revise README for clarity on firmware and USB
    Updated README to clarify firmware and USB device details.
2026-10-26 time: add the cached frame_time time base
    - Universal.h provides frame_time / frameTimeUpdate() / getFrameTime(); loop()
    calls frameTimeUpdate() first, so any future timing logic (long press, combo,
    animations) can read one consistent value per frame instead of calling
    millis() repeatedly (which disables interrupts and can straddle a tick)
    - README (both languages): short section documenting the convention
2026-11-04 1.12: WS2812B LED effects, sticky/rapid behaviours, repeat-params protocol, struct key state
2026-11-06 rtkb: keep LED effects disabled (ADC power noise) with explanation; fix MAP_TYPE aliases
